nightt5879/HT_2023/通信协议.docx

通信协议

使用的串口为UART0，波特率为115200。数据固定为四个字节的数据。格式与作用如下所示：

0 | 1 | 2 | 3
帧头 | 数据含义 | 高八位 | 低八位
0xAA | 0x | 0x | 0x

数据含义：

0x02：发送图片（HT32 to 8266）

这里就没有数据了，高八低八直接写0x00了。

识别是否成功（8266 to HT32）

单字符：

0x00：失败

0x01：成功

URAT1:to su-o3T 115200，UART0：HT32 to ESP8266

数据分为两种，分别为带数据的和不带数据的。

①带数据的：

1 | 2 | 3 | 4 | 5 | 6 | 7
帧头 | | 序号 | 变量a | 变量b | 帧尾
0x55 | 0xAA | 0x | 0x | 0x | 0x55 | 0xAA

本次通信中主要用于发送温度数据

播报哪种情况根据序号不同有变化

1：温度正常 2：温度过高 3：温度过低
转换之后分为整数部分（a）和小数部分（b）

②不带数据的：

1 | 2 | 3 | 4 | 5
帧头 | | 序号 | 帧尾
0x55 | 0xAA | 0x | 0x55 | 0xAA

主要用于触发固定的语音。

改变序号即可

4：人脸检测成功 5：人脸检测失败 6：完成录入 7：人脸失败过多 8：测温失败过多
