nightt5879/HT_2023/Holtek HT32init/TPMakerExe/_TPMaker/default.ini

[SETTING]
TitleString=Holtek TinyPorgrammer V1.0.0
TextString=TinyPorgrammer for Holtek. Version V1.0.0
NoteString=Type note here, maximum 100 characters.
ImagePath1=
ImagePath2=
VersionString=V1.0.0
APVIDString=0000
APPIDString=0000
APINFString=00
IAPVIDString=0000
IAPPIDString=0000
IAPINFString=00
IDigestEn=1
IDIGESTString=0000
CMDKEYPath=
CMDKEYEn=1
