nightt5879/HT_2023/Holtek HT32init/TPMakerExe/_TPMaker/setting.ini

[SETTING]
TitleString=HT32 IAP
TextString=HT32 IAP
NoteString=HT32 IAP
ImagePath1=.\Image\20181025_V100_AP_Encrypt.bin
ImagePath2=
VersionString=V100
APVIDString=1234
APPIDString=0002
APINFString=00
IAPVIDString=1234
IAPPIDString=0001
IAPINFString=00
IDigestEn=1
IDIGESTString=Console mode error!
CMDKEYPath=.\Config\Command_Key.bin
CMDKEYEn=1
