nightt5879/HT_2023/Holtek HT32init/HT32_M0+/USBDemo/Mass_Storage/ram_disk.c

/*********************************************************************************************************//**
 * @file    USBD/Mass_Storage/ram_disk.c
 * @version $Rev:: 330          $
 * @date    $Date:: 2016-04-14 #$
 * @brief   The RAM Disk related function.
 *************************************************************************************************************
 * @attention
 *
 * Firmware Disclaimer Information
 *
 * 1. The customer hereby acknowledges and agrees that the program technical documentation, including the
 *    code, which is supplied by Holtek Semiconductor Inc., (hereinafter referred to as "HOLTEK") is the
 *    proprietary and confidential intellectual property of HOLTEK, and is protected by copyright law and
 *    other intellectual property laws.
 *
 * 2. The customer hereby acknowledges and agrees that the program technical documentation, including the
 *    code, is confidential information belonging to HOLTEK, and must not be disclosed to any third parties
 *    other than HOLTEK and the customer.
 *
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
 * <h2><center>Copyright (C) Holtek Semiconductor Inc. All rights reserved</center></h2>
 ************************************************************************************************************/

/* Includes ------------------------------------------------------------------------------------------------*/
#include "ram_disk.h"

/** @addtogroup HT32_Series_Peripheral_Examples HT32 Peripheral Examples
  * @{
  */

/** @addtogroup USBD_Examples USBD
  * @{
  */

/** @addtogroup Mass_Storage
  * @{
  */


/* Private macro -------------------------------------------------------------------------------------------*/
#define HALT_2_BYTE(Val)                     ((u8)(Val & 0x00FF)), ((u8)((Val & 0xFF00) >> 8))
#define WORD_2_BYTE(Val)                     ((u8)((Val & 0x000000FF) >> 0 )), \
                                             ((u8)((Val & 0x0000FF00) >> 8 )), \
                                             ((u8)((Val & 0x00FF0000) >> 16)), \
                                             ((u8)((Val & 0xFF000000) >> 24))

/* Private variables ---------------------------------------------------------------------------------------*/
__ALIGN4 static u8 guMemory0[RAMDISK0_MemorySize] =
{
/* BOOT (512 Bytes)                                                                                         */
0xEB, 60, 0x90,                                 /* Dummy jump instruction:                                  */
'M', 'S', 'D', 'O', 'S', '5', '.', '0',         /* OEM Name:                                                */
                                                /* DOS 3.0 BPB                                              */
0x00, 0x02,                                     /* Bytes per logical sector                                 */
0x01,                                           /* Logical sectors per cluster                              */
0x01, 0x00,                                     /* Reserved logical sector count                            */
0x01,                                           /* Number of File Allocation Tables                         */
0x10, 0x00,                                     /* Maximum number of FAT root directory entries (nx32 Bytes)*/
HALT_2_BYTE(RAMDISK0_BlockCount),               /* Total logical sectors                                    */
0xF8,                                           /* Media descriptor                                         */
0x01, 0x00,                                     /* Logical sectors per File Allocation Table                */

0x01, 0x00,                                     /* Sectors per track for disks                              */
0x01, 0x00,                                     /* Number of heads for disks                                */

0x00, 0x00, 0x00, 0x00,                         /* Count of hidden sectors preceding the partition          */
0x00, 0x00, 0x00, 0x00,                         /* Total logical sectors (if greater than 65535)            */
0x00,                                           /* Physical drive number, 00 for first removable media      */
0x00,                                           /* Reserved                                                 */
0x29,                                           /* Extended boot signature                                  */
0x04, 0x03, 0x02, 0x01,                         /* Volume ID (serial number)                                */
'H', 'O', 'L', 'T', 'E', 'K', ' ', 'D',         /* Partition Volume Label                                   */
'I', 'S', 'K',
'F', 'A', 'T', '1', '2', ' ', ' ', ' ',         /* File system type (FAT12)                                 */

0x33, 0xC9,
0x8E, 0xD1, 0xBC, 0xF0, 0x7B, 0x8E, 0xD9, 0xB8, 0x00, 0x20, 0x8E, 0xC0, 0xFC, 0xBD, 0x00, 0x7C,
0x38, 0x4E, 0x24, 0x7D, 0x24, 0x8B, 0xC1, 0x99, 0xE8, 0x3C, 0x01, 0x72, 0x1C, 0x83, 0xEB, 0x3A,
0x66, 0xA1, 0x1C, 0x7C, 0x26, 0x66, 0x3B, 0x07, 0x26, 0x8A, 0x57, 0xFC, 0x75, 0x06, 0x80, 0xCA,
0x02, 0x88, 0x56, 0x02, 0x80, 0xC3, 0x10, 0x73, 0xEB, 0x33, 0xC9, 0x8A, 0x46, 0x10, 0x98, 0xF7,
0x66, 0x16, 0x03, 0x46, 0x1C, 0x13, 0x56, 0x1E, 0x03, 0x46, 0x0E, 0x13, 0xD1, 0x8B, 0x76, 0x11,
0x60, 0x89, 0x46, 0xFC, 0x89, 0x56, 0xFE, 0xB8, 0x20, 0x00, 0xF7, 0xE6, 0x8B, 0x5E, 0x0B, 0x03,
0xC3, 0x48, 0xF7, 0xF3, 0x01, 0x46, 0xFC, 0x11, 0x4E, 0xFE, 0x61, 0xBF, 0x00, 0x00, 0xE8, 0xE6,
0x00, 0x72, 0x39, 0x26, 0x38, 0x2D, 0x74, 0x17, 0x60, 0xB1, 0x0B, 0xBE, 0xA1, 0x7D, 0xF3, 0xA6,
0x61, 0x74, 0x32, 0x4E, 0x74, 0x09, 0x83, 0xC7, 0x20, 0x3B, 0xFB, 0x72, 0xE6, 0xEB, 0xDC, 0xA0,
0xFB, 0x7D, 0xB4, 0x7D, 0x8B, 0xF0, 0xAC, 0x98, 0x40, 0x74, 0x0C, 0x48, 0x74, 0x13, 0xB4, 0x0E,
0xBB, 0x07, 0x00, 0xCD, 0x10, 0xEB, 0xEF, 0xA0, 0xFD, 0x7D, 0xEB, 0xE6, 0xA0, 0xFC, 0x7D, 0xEB,
0xE1, 0xCD, 0x16, 0xCD, 0x19, 0x26, 0x8B, 0x55, 0x1A, 0x52, 0xB0, 0x01, 0xBB, 0x00, 0x00, 0xE8,
0x3B, 0x00, 0x72, 0xE8, 0x5B, 0x8A, 0x56, 0x24, 0xBE, 0x0B, 0x7C, 0x8B, 0xFC, 0xC7, 0x46, 0xF0,
0x3D, 0x7D, 0xC7, 0x46, 0xF4, 0x29, 0x7D, 0x8C, 0xD9, 0x89, 0x4E, 0xF2, 0x89, 0x4E, 0xF6, 0xC6,
0x06, 0x96, 0x7D, 0xCB, 0xEA, 0x03, 0x00, 0x00, 0x20, 0x0F, 0xB6, 0xC8, 0x66, 0x8B, 0x46, 0xF8,
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
0x00, 0x00, 0x00, 0x00, 0x00, 0x00, 0x00, 0x00, 0x00, 0x00, 0x00, 0x00, 0x00, 0x00, 0x00, 0x00,
0x00, 0x00, 0x00, 0x00, 0x00, 0x00, 0x00, 0x00, 0x00, 0x00, 0x00, 0x00, 0x00, 0x00, 0x00, 0x00,
0x00, 0x00, 0x00, 0x00, 0x00, 0x00, 0x00, 0x00, 0x00, 0x00, 0x00, 0x00, 0x00, 0x00, 0x00, 0x00,
0x00, 0x00, 0x00, 0x00, 0x00, 0x00, 0x00, 0x00, 0x00, 0x00, 0x00, 0x00, 0x00, 0x00, 0x00, 0x00,
0x00, 0x00, 0x00, 0x00, 0x00, 0x00, 0x00, 0x00, 0x00, 0x00, 0x00, 0x00, 0x00, 0x00, 0x00, 0x00,
0x00, 0x00, 0x00, 0x00, 0x00, 0x00, 0x00, 0x00, 0x00, 0x00, 0x00, 0x00, 0x00,

/* Root (512 Bytes)                                                                                         */
'H' , 'o' , 'l' , 't' , 'e' , 'k' , ' ' , 'D' , /* Short file name                                          */
'i' , 's' , 'k' ,                               /* Short file extension                                     */
0x28,                                           /* File Attributes: 0x28 for Volume Label                   */
0x00, 0x00, 0x00, 0x00,
0x00, 0x00,
0x00, 0x00, 0x00, 0x00, 0x00, 0x00, 0x00, 0x00, 0x00, 0x00, 0x00, 0x00, 0x00, 0x00,

'R' , 'E' , 'A' , 'D' , 'M' , 'E' , ' ' , ' ' , /* Short file name                                          */
'T' , 'X' , 'T' ,                               /* Short file extension                                     */
0x21,                                           /* File Attributes: 0x21 for read only Archive              */
0x00, 0x00,                                     /* Reserved                                                 */
0x42, 0x08,                                     /* Create time                                              */
0x2A, 0x40,                                     /* Create date                                              */
0x3E, 0x40,                                     /* Last access date                                         */
0x00, 0x00,                                     /* Reserved                                                 */
0x10, 0xA2,                                     /* Last modified time                                       */
0x34, 0x40,                                     /* Last modified date                                       */
0x02, 0x00,                                     /* Start of file in clusters                                */
WORD_2_BYTE(55),                                /* File size in bytes                                       */

0x00, 0x00, 0x00, 0x00, 0x00, 0x00, 0x00, 0x00, 0x00, 0x00, 0x00, 0x00, 0x00, 0x00, 0x00, 0x00,
0x00, 0x00, 0x00, 0x00, 0x00, 0x00, 0x00, 0x00, 0x00, 0x00, 0x00, 0x00, 0x00, 0x00, 0x00, 0x00,
0x00, 0x00, 0x00, 0x00, 0x00, 0x00, 0x00, 0x00, 0x00, 0x00, 0x00, 0x00, 0x00, 0x00, 0x00, 0x00,
0x00, 0x00, 0x00, 0x00, 0x00, 0x00, 0x00, 0x00, 0x00, 0x00, 0x00, 0x00, 0x00, 0x00, 0x00, 0x00,
0x00, 0x00, 0x00, 0x00, 0x00, 0x00, 0x00, 0x00, 0x00, 0x00, 0x00, 0x00, 0x00, 0x00, 0x00, 0x00,
0x00, 0x00, 0x00, 0x00, 0x00, 0x00, 0x00, 0x00, 0x00, 0x00, 0x00, 0x00, 0x00, 0x00, 0x00, 0x00,
0x00, 0x00, 0x00, 0x00, 0x00, 0x00, 0x00, 0x00, 0x00, 0x00, 0x00, 0x00, 0x00, 0x00, 0x00, 0x00,
0x00, 0x00, 0x00, 0x00, 0x00, 0x00, 0x00, 0x00, 0x00, 0x00, 0x00, 0x00, 0x00, 0x00, 0x00, 0x00,
0x00, 0x00, 0x00, 0x00, 0x00, 0x00, 0x00, 0x00, 0x00, 0x00, 0x00, 0x00, 0x00, 0x00, 0x00, 0x00,
0x00, 0x00, 0x00, 0x00, 0x00, 0x00, 0x00, 0x00, 0x00, 0x00, 0x00, 0x00, 0x00, 0x00, 0x00, 0x00,
0x00, 0x00, 0x00, 0x00, 0x00, 0x00, 0x00, 0x00, 0x00, 0x00, 0x00, 0x00, 0x00, 0x00, 0x00, 0x00,
0x00, 0x00, 0x00, 0x00, 0x00, 0x00, 0x00, 0x00, 0x00, 0x00, 0x00, 0x00, 0x00, 0x00, 0x00, 0x00,
0x00, 0x00, 0x00, 0x00, 0x00, 0x00, 0x00, 0x00, 0x00, 0x00, 0x00, 0x00, 0x00, 0x00, 0x00, 0x00,
0x00, 0x00, 0x00, 0x00, 0x00, 0x00, 0x00, 0x00, 0x00, 0x00, 0x00, 0x00, 0x00, 0x00, 0x00, 0x00,
0x00, 0x00, 0x00, 0x00, 0x00, 0x00, 0x00, 0x00, 0x00, 0x00, 0x00, 0x00, 0x00, 0x00, 0x00, 0x00,
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
0x00, 0x00, 0x00, 0x00, 0x00, 0x00, 0x00, 0x00, 0x00, 0x00, 0x00, 0x00, 0x00, 0x00, 0x00, 0x00,
0x00, 0x00, 0x00, 0x00, 0x00, 0x00, 0x00, 0x00, 0x00, 0x00, 0x00, 0x00, 0x00, 0x00, 0x00, 0x00,
0x00, 0x00, 0x00, 0x00, 0x00, 0x00, 0x00, 0x00, 0x00, 0x00, 0x00, 0x00, 0x00, 0x00, 0x00, 0x00,
0x00, 0x00, 0x00, 0x00, 0x00, 0x00, 0x00, 0x00, 0x00, 0x00, 0x00, 0x00, 0x00, 0x00, 0x00, 0x00,
};

#if (BOT_RAM_DISK1 == 1)
__ALIGN4 static u8 guMemory1[RAMDISK1_MemorySize] =
{
/* BOOT (512 Bytes)                                                                                         */
0xEB, 60, 0x90,                                 /* Dummy jump instruction:                                  */
'M', 'S', 'D', 'O', 'S', '5', '.', '0',         /* OEM Name:                                                */
                                                /* DOS 3.0 BPB                                              */
0x00, 0x02,                                     /* Bytes per logical sector                                 */
0x01,                                           /* Logical sectors per cluster                              */
0x01, 0x00,                                     /* Reserved logical sector count                            */
0x01,                                           /* Number of File Allocation Tables                         */
0x10, 0x00,                                     /* Maximum number of FAT root directory entries (nx32 Bytes)*/
HALT_2_BYTE(RAMDISK1_BlockCount),               /* Total logical sectors                                    */
0xF8,                                           /* Media descriptor                                         */
0x01, 0x00,                                     /* Logical sectors per File Allocation Table                */

0x01, 0x00,                                     /* Sectors per track for disks                              */
0x01, 0x00,                                     /* Number of heads for disks                                */

0x00, 0x00, 0x00, 0x00,                         /* Count of hidden sectors preceding the partition          */
0x00, 0x00, 0x00, 0x00,                         /* Total logical sectors (if greater than 65535)            */
0x00,                                           /* Physical drive number, 00 for first removable media      */
0x00,                                           /* Reserved                                                 */
0x29,                                           /* Extended boot signature                                  */
0x04, 0x03, 0x02, 0x01,                         /* Volume ID (serial number)                                */
'H', 'O', 'L', 'T', 'E', 'K', ' ', 'D',         /* Partition Volume Label                                   */
'I', 'S', 'K',
'F', 'A', 'T', '1', '2', ' ', ' ', ' ',         /* File system type (FAT12)                                 */

0x33, 0xC9,
0x8E, 0xD1, 0xBC, 0xF0, 0x7B, 0x8E, 0xD9, 0xB8, 0x00, 0x20, 0x8E, 0xC0, 0xFC, 0xBD, 0x00, 0x7C,
0x38, 0x4E, 0x24, 0x7D, 0x24, 0x8B, 0xC1, 0x99, 0xE8, 0x3C, 0x01, 0x72, 0x1C, 0x83, 0xEB, 0x3A,
0x66, 0xA1, 0x1C, 0x7C, 0x26, 0x66, 0x3B, 0x07, 0x26, 0x8A, 0x57, 0xFC, 0x75, 0x06, 0x80, 0xCA,
0x02, 0x88, 0x56, 0x02, 0x80, 0xC3, 0x10, 0x73, 0xEB, 0x33, 0xC9, 0x8A, 0x46, 0x10, 0x98, 0xF7,
0x66, 0x16, 0x03, 0x46, 0x1C, 0x13, 0x56, 0x1E, 0x03, 0x46, 0x0E, 0x13, 0xD1, 0x8B, 0x76, 0x11,
0x60, 0x89, 0x46, 0xFC, 0x89, 0x56, 0xFE, 0xB8, 0x20, 0x00, 0xF7, 0xE6, 0x8B, 0x5E, 0x0B, 0x03,
0xC3, 0x48, 0xF7, 0xF3, 0x01, 0x46, 0xFC, 0x11, 0x4E, 0xFE, 0x61, 0xBF, 0x00, 0x00, 0xE8, 0xE6,
0x00, 0x72, 0x39, 0x26, 0x38, 0x2D, 0x74, 0x17, 0x60, 0xB1, 0x0B, 0xBE, 0xA1, 0x7D, 0xF3, 0xA6,
0x61, 0x74, 0x32, 0x4E, 0x74, 0x09, 0x83, 0xC7, 0x20, 0x3B, 0xFB, 0x72, 0xE6, 0xEB, 0xDC, 0xA0,
0xFB, 0x7D, 0xB4, 0x7D, 0x8B, 0xF0, 0xAC, 0x98, 0x40, 0x74, 0x0C, 0x48, 0x74, 0x13, 0xB4, 0x0E,
0xBB, 0x07, 0x00, 0xCD, 0x10, 0xEB, 0xEF, 0xA0, 0xFD, 0x7D, 0xEB, 0xE6, 0xA0, 0xFC, 0x7D, 0xEB,
0xE1, 0xCD, 0x16, 0xCD, 0x19, 0x26, 0x8B, 0x55, 0x1A, 0x52, 0xB0, 0x01, 0xBB, 0x00, 0x00, 0xE8,
0x3B, 0x00, 0x72, 0xE8, 0x5B, 0x8A, 0x56, 0x24, 0xBE, 0x0B, 0x7C, 0x8B, 0xFC, 0xC7, 0x46, 0xF0,
0x3D, 0x7D, 0xC7, 0x46, 0xF4, 0x29, 0x7D, 0x8C, 0xD9, 0x89, 0x4E, 0xF2, 0x89, 0x4E, 0xF6, 0xC6,
0x06, 0x96, 0x7D, 0xCB, 0xEA, 0x03, 0x00, 0x00, 0x20, 0x0F, 0xB6, 0xC8, 0x66, 0x8B, 0x46, 0xF8,
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
0x00, 0x00, 0x00, 0x00, 0x00, 0x00, 0x00, 0x00, 0x00, 0x00, 0x00, 0x00, 0x00, 0x00, 0x00, 0x00,
0x00, 0x00, 0x00, 0x00, 0x00, 0x00, 0x00, 0x00, 0x00, 0x00, 0x00, 0x00, 0x00, 0x00, 0x00, 0x00,
0x00, 0x00, 0x00, 0x00, 0x00, 0x00, 0x00, 0x00, 0x00, 0x00, 0x00, 0x00, 0x00, 0x00, 0x00, 0x00,
0x00, 0x00, 0x00, 0x00, 0x00, 0x00, 0x00, 0x00, 0x00, 0x00, 0x00, 0x00, 0x00, 0x00, 0x00, 0x00,
0x00, 0x00, 0x00, 0x00, 0x00, 0x00, 0x00, 0x00, 0x00, 0x00, 0x00, 0x00, 0x00, 0x00, 0x00, 0x00,
0x00, 0x00, 0x00, 0x00, 0x00, 0x00, 0x00, 0x00, 0x00, 0x00, 0x00, 0x00, 0x00,

/* Root (512 Bytes)                                                                                         */
'H' , 'o' , 'l' , 't' , 'e' , 'k' , ' ' , 'D' , /* Short file name                                          */
'i' , 's' , 'k' ,                               /* Short file extension                                     */
0x28,                                           /* File Attributes: 0x28 for Volume Label                   */
0x00, 0x00, 0x00, 0x00,
0x00, 0x00,
0x00, 0x00, 0x00, 0x00, 0x00, 0x00, 0x00, 0x00, 0x00, 0x00, 0x00, 0x00, 0x00, 0x00,

'R' , 'E' , 'A' , 'D' , 'M' , 'E' , ' ' , ' ' , /* Short file name                                          */
'T' , 'X' , 'T' ,                               /* Short file extension                                     */
0x21,                                           /* File Attributes: 0x21 for read only Archive              */
0x00, 0x00,                                     /* Reserved                                                 */
0x42, 0x08,                                     /* Create time                                              */
0x2A, 0x40,                                     /* Create date                                              */
0x3E, 0x40,                                     /* Last access date                                         */
0x00, 0x00,                                     /* Reserved                                                 */
0x10, 0xA2,                                     /* Last modified time                                       */
0x34, 0x40,                                     /* Last modified date                                       */
0x02, 0x00,                                     /* Start of file in clusters                                */
WORD_2_BYTE(55),                                /* File size in bytes                                       */

0x00, 0x00, 0x00, 0x00, 0x00, 0x00, 0x00, 0x00, 0x00, 0x00, 0x00, 0x00, 0x00, 0x00, 0x00, 0x00,
0x00, 0x00, 0x00, 0x00, 0x00, 0x00, 0x00, 0x00, 0x00, 0x00, 0x00, 0x00, 0x00, 0x00, 0x00, 0x00,
0x00, 0x00, 0x00, 0x00, 0x00, 0x00, 0x00, 0x00, 0x00, 0x00, 0x00, 0x00, 0x00, 0x00, 0x00, 0x00,
0x00, 0x00, 0x00, 0x00, 0x00, 0x00, 0x00, 0x00, 0x00, 0x00, 0x00, 0x00, 0x00, 0x00, 0x00, 0x00,
0x00, 0x00, 0x00, 0x00, 0x00, 0x00, 0x00, 0x00, 0x00, 0x00, 0x00, 0x00, 0x00, 0x00, 0x00, 0x00,
0x00, 0x00, 0x00, 0x00, 0x00, 0x00, 0x00, 0x00, 0x00, 0x00, 0x00, 0x00, 0x00, 0x00, 0x00, 0x00,
0x00, 0x00, 0x00, 0x00, 0x00, 0x00, 0x00, 0x00, 0x00, 0x00, 0x00, 0x00, 0x00, 0x00, 0x00, 0x00,
0x00, 0x00, 0x00, 0x00, 0x00, 0x00, 0x00, 0x00, 0x00, 0x00, 0x00, 0x00, 0x00, 0x00, 0x00, 0x00,
0x00, 0x00, 0x00, 0x00, 0x00, 0x00, 0x00, 0x00, 0x00, 0x00, 0x00, 0x00, 0x00, 0x00, 0x00, 0x00,
0x00, 0x00, 0x00, 0x00, 0x00, 0x00, 0x00, 0x00, 0x00, 0x00, 0x00, 0x00, 0x00, 0x00, 0x00, 0x00,
0x00, 0x00, 0x00, 0x00, 0x00, 0x00, 0x00, 0x00, 0x00, 0x00, 0x00, 0x00, 0x00, 0x00, 0x00, 0x00,
0x00, 0x00, 0x00, 0x00, 0x00, 0x00, 0x00, 0x00, 0x00, 0x00, 0x00, 0x00, 0x00, 0x00, 0x00, 0x00,
0x00, 0x00, 0x00, 0x00, 0x00, 0x00, 0x00, 0x00, 0x00, 0x00, 0x00, 0x00, 0x00, 0x00, 0x00, 0x00,
0x00, 0x00, 0x00, 0x00, 0x00, 0x00, 0x00, 0x00, 0x00, 0x00, 0x00, 0x00, 0x00, 0x00, 0x00, 0x00,
0x00, 0x00, 0x00, 0x00, 0x00, 0x00, 0x00, 0x00, 0x00, 0x00, 0x00, 0x00, 0x00, 0x00, 0x00, 0x00,
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
0x00, 0x00, 0x00, 0x00, 0x00, 0x00, 0x00, 0x00, 0x00, 0x00, 0x00, 0x00, 0x00, 0x00, 0x00, 0x00,
0x00, 0x00, 0x00, 0x00, 0x00, 0x00, 0x00, 0x00, 0x00, 0x00, 0x00, 0x00, 0x00, 0x00, 0x00, 0x00,
0x00, 0x00, 0x00, 0x00, 0x00, 0x00, 0x00, 0x00, 0x00, 0x00, 0x00, 0x00, 0x00, 0x00, 0x00, 0x00,
0x00, 0x00, 0x00, 0x00, 0x00, 0x00, 0x00, 0x00, 0x00, 0x00, 0x00, 0x00, 0x00, 0x00, 0x00, 0x00,
};
#endif

u8 bRamDiskUnload[2] = {FALSE};

/* Global functions ----------------------------------------------------------------------------------------*/
/*********************************************************************************************************//**
  * @brief  Read from RAM Disk memory.
  * @param  uId: RAM Disk ID
  * @param  pBuffer: Pointer of data buffer
  * @param  uAddress: Address for read operation
  * @param  uLength: Length for read operation
  * @retval uResult: TRUE or FALSE
  ***********************************************************************************************************/
u32 RAMDISK_Read(u32 uId, u8 **pBuffer, u32 uAddress, u32 uLength)
{
  u32 uResult = TRUE;

  if (uId == RAMDISK0_ID)
  {
    *pBuffer = &(guMemory0[uAddress]);
  }
  #if (BOT_RAM_DISK1 == 1)
  else if (uId == RAMDISK1_ID)
  {
    *pBuffer = &(guMemory1[uAddress]);
  }
  #endif
  else
  {
    uResult = FALSE;
  }

  return uResult;
}

/*********************************************************************************************************//**
  * @brief  Write to RAM Disk memory.
  * @param  uId: RAM Disk ID
  * @param  pBuffer: Pointer of data buffer
  * @param  uAddress: Address for write operation
  * @param  uLength: Length for write operation
  * @retval TRUE or FALSE
  ***********************************************************************************************************/
u32 RAMDISK_Write(u32 uId, u8 *pBuffer, u32 uAddress, u32 uLength)
{
  s32 i;
  u8 *pMemory;

  if (uId == RAMDISK0_ID)
  {
    pMemory = &(guMemory0[uAddress]);
  }
  #if (BOT_RAM_DISK1 == 1)
  else if (uId == RAMDISK1_ID)
  {
    pMemory = &(guMemory1[uAddress]);
  }
  #endif
  else
  {
    return FALSE;
  }

  for (i = uLength - 1; i >= 0; i--)
  {
    pMemory[i] = *(pBuffer + i);
  }

  return TRUE;
}

/*********************************************************************************************************//**
  * @brief  Get RAM Disk Status.
  * @param  uId: RAM Disk ID
  * @param  pSizeInfo: Pointer of media size information
  * @retval TRUE: Always ready for RAM disk
  ***********************************************************************************************************/
u32 RAMDISK_GetStatus(u32 uId, BOT_MediaSize_Typedef *pSizeInfo)
{
  if ((uId == RAMDISK0_ID) && bRamDiskUnload[0])
    return FALSE;
  else if ((uId == RAMDISK1_ID) && bRamDiskUnload[1])
    return FALSE;

  return TRUE;
}

/*********************************************************************************************************//**
  * @brief  Unmount RAM Disk.
  * @param  uId: RAM Disk ID
  ***********************************************************************************************************/
void RAMDISK_Unmount(u32 uId)
{
  if (uId == RAMDISK0_ID)
    bRamDiskUnload[0] = TRUE;
  else if (uId == RAMDISK1_ID)
    bRamDiskUnload[1] = TRUE;
}


/**
  * @}
  */

/**
  * @}
  */

/**
  * @}
  */
