nightt5879/HT_2023/su-03t/jx_firm (7)/jx_firm/uart/jx_uart_send.c

#include "jx_uart_send.h"

// 串口通信消息头
const unsigned char g_uart_send_head[] = {
  0xaa, 0x55
};

// 串口通信消息尾
const unsigned char g_uart_send_foot[] = {
  0x55, 0xaa
};

// 串口发送函数实现
void _uart_send_impl(unsigned char* buff, int len) {
  // TODO: 调用项目实际的串口发送函数
  /*
  int i = 0;
  unsigned char c;
  for (i = 0; i < len; i++) {
    c = buff[i];
    printf("%02X ", c);
  }
  printf("\n");
  */
}

// action: tem_nor
void _uart_tem_nor(char a, char b) {
  uart_param_t param;
  int i = 0;
  unsigned char buff[UART_SEND_MAX] = {0};
  for (i = 0; i < UART_MSG_HEAD_LEN; i++) {
      buff[i + 0] = g_uart_send_head[i];
  }
  buff[2] = U_MSG_tem_nor;
  param.d_char = a;
  buff[3] = param.d_uchar;
  param.d_char = b;
  buff[4] = param.d_uchar;
  for (i = 0; i < UART_MSG_FOOT_LEN; i++) {
      buff[i + 5] = g_uart_send_foot[i];
  }
  _uart_send_impl(buff, 7);
}

// action: tem_high
void _uart_tem_high(char a, char b) {
  uart_param_t param;
  int i = 0;
  unsigned char buff[UART_SEND_MAX] = {0};
  for (i = 0; i < UART_MSG_HEAD_LEN; i++) {
      buff[i + 0] = g_uart_send_head[i];
  }
  buff[2] = U_MSG_tem_high;
  param.d_char = a;
  buff[3] = param.d_uchar;
  param.d_char = b;
  buff[4] = param.d_uchar;
  for (i = 0; i < UART_MSG_FOOT_LEN; i++) {
      buff[i + 5] = g_uart_send_foot[i];
  }
  _uart_send_impl(buff, 7);
}

// action: tem_low
void _uart_tem_low(char a, char b) {
  uart_param_t param;
  int i = 0;
  unsigned char buff[UART_SEND_MAX] = {0};
  for (i = 0; i < UART_MSG_HEAD_LEN; i++) {
      buff[i + 0] = g_uart_send_head[i];
  }
  buff[2] = U_MSG_tem_low;
  param.d_char = a;
  buff[3] = param.d_uchar;
  param.d_char = b;
  buff[4] = param.d_uchar;
  for (i = 0; i < UART_MSG_FOOT_LEN; i++) {
      buff[i + 5] = g_uart_send_foot[i];
  }
  _uart_send_impl(buff, 7);
}

// action: face_suc
void _uart_face_suc() {
  uart_param_t param;
  int i = 0;
  unsigned char buff[UART_SEND_MAX] = {0};
  for (i = 0; i < UART_MSG_HEAD_LEN; i++) {
      buff[i + 0] = g_uart_send_head[i];
  }
  buff[2] = U_MSG_face_suc;
  for (i = 0; i < UART_MSG_FOOT_LEN; i++) {
      buff[i + 3] = g_uart_send_foot[i];
  }
  _uart_send_impl(buff, 5);
}

// action: face_fail
void _uart_face_fail() {
  uart_param_t param;
  int i = 0;
  unsigned char buff[UART_SEND_MAX] = {0};
  for (i = 0; i < UART_MSG_HEAD_LEN; i++) {
      buff[i + 0] = g_uart_send_head[i];
  }
  buff[2] = U_MSG_face_fail;
  for (i = 0; i < UART_MSG_FOOT_LEN; i++) {
      buff[i + 3] = g_uart_send_foot[i];
  }
  _uart_send_impl(buff, 5);
}

// action: finish
void _uart_finish() {
  uart_param_t param;
  int i = 0;
  unsigned char buff[UART_SEND_MAX] = {0};
  for (i = 0; i < UART_MSG_HEAD_LEN; i++) {
      buff[i + 0] = g_uart_send_head[i];
  }
  buff[2] = U_MSG_finish;
  for (i = 0; i < UART_MSG_FOOT_LEN; i++) {
      buff[i + 3] = g_uart_send_foot[i];
  }
  _uart_send_impl(buff, 5);
}

// action: face_out
void _uart_face_out() {
  uart_param_t param;
  int i = 0;
  unsigned char buff[UART_SEND_MAX] = {0};
  for (i = 0; i < UART_MSG_HEAD_LEN; i++) {
      buff[i + 0] = g_uart_send_head[i];
  }
  buff[2] = U_MSG_face_out;
  for (i = 0; i < UART_MSG_FOOT_LEN; i++) {
      buff[i + 3] = g_uart_send_foot[i];
  }
  _uart_send_impl(buff, 5);
}

// action: tem_out
void _uart_tem_out() {
  uart_param_t param;
  int i = 0;
  unsigned char buff[UART_SEND_MAX] = {0};
  for (i = 0; i < UART_MSG_HEAD_LEN; i++) {
      buff[i + 0] = g_uart_send_head[i];
  }
  buff[2] = U_MSG_tem_out;
  for (i = 0; i < UART_MSG_FOOT_LEN; i++) {
      buff[i + 3] = g_uart_send_foot[i];
  }
  _uart_send_impl(buff, 5);
}
