nightt5879/HT_2023/su-03t/jx_firm (7)/jx_firm/uart/jx_uart_send.h

#ifndef JX_UART_SEND_H_
#define JX_UART_SEND_H_

#ifdef __cplusplus
extern "C" {
#endif

// 串口发送消息最大长度
#define UART_SEND_MAX      32
#define UART_MSG_HEAD_LEN  2
#define UART_MSG_FOOT_LEN  2

// 串口发送消息号
#define U_MSG_tem_nor      1
#define U_MSG_tem_high      2
#define U_MSG_tem_low      3
#define U_MSG_face_suc      4
#define U_MSG_face_fail      5
#define U_MSG_finish      6
#define U_MSG_face_out      7
#define U_MSG_tem_out      8

// 串口消息参数类型
typedef union {
  double d_double;
  int d_int;
  unsigned char d_ucs[8];
  char d_char;
  unsigned char d_uchar;
  unsigned long d_long;
  short d_short;
  float d_float;
}uart_param_t;

// 十六位整数转32位整数
void _int16_to_int32(uart_param_t* param) {
  if (sizeof(int) >= 4)
    return;
  unsigned long value = param->d_long;
  unsigned long sign = (value >> 15) & 1;
  unsigned long v = value;
  if (sign)
    v = 0xFFFF0000 | value;
  uart_param_t p;
  p.d_long = v;
  param->d_ucs[0] = p.d_ucs[0];
  param->d_ucs[1] = p.d_ucs[1];
  param->d_ucs[2] = p.d_ucs[2];
  param->d_ucs[3] = p.d_ucs[3];
}

// 浮点数转双精度 
void _float_to_double(uart_param_t* param) {
  if (sizeof(int) >= 4)
    return;
  unsigned long value = param->d_long;
  unsigned long sign = value >> 31;
  unsigned long M = value & 0x007FFFFF;
  unsigned long e =  ((value >> 23 ) & 0xFF) - 127 + 1023;
  uart_param_t p0, p1;  
  p1.d_long = ((sign & 1) << 31) | ((e & 0x7FF) << 20) | (M >> 3);
  p0.d_long = (M & 0x7) << 29;
  param->d_ucs[0] = p0.d_ucs[0];
  param->d_ucs[1] = p0.d_ucs[1];
  param->d_ucs[2] = p0.d_ucs[2];
  param->d_ucs[3] = p0.d_ucs[3];
  param->d_ucs[4] = p1.d_ucs[0];
  param->d_ucs[5] = p1.d_ucs[1];
  param->d_ucs[6] = p1.d_ucs[2];
  param->d_ucs[7] = p1.d_ucs[3];
}

// action: tem_nor
void _uart_tem_nor(char a, char b);

// action: tem_high
void _uart_tem_high(char a, char b);

// action: tem_low
void _uart_tem_low(char a, char b);

// action: face_suc
void _uart_face_suc();

// action: face_fail
void _uart_face_fail();

// action: finish
void _uart_finish();

// action: face_out
void _uart_face_out();

// action: tem_out
void _uart_tem_out();

#ifdef __cplusplus
}
#endif

#endif /*JX_UART_SEND_H_*/
