nightt5879/HT_2023/Holtek HT32init/HT32_M0+/project_template/IP/Example/ht32f5xxxx_01_it.c

/*********************************************************************************************************//**
 * @file    IP/Example/ht32f5xxxx_01_it.c
 * @version $Rev:: 4398         $
 * @date    $Date:: 2019-11-14 #$
 * @brief   This file provides all interrupt service routine.
 *************************************************************************************************************
 * @attention
 *
 * Firmware Disclaimer Information
 *
 * 1. The customer hereby acknowledges and agrees that the program technical documentation, including the
 *    code, which is supplied by Holtek Semiconductor Inc., (hereinafter referred to as "HOLTEK") is the
 *    proprietary and confidential intellectual property of HOLTEK, and is protected by copyright law and
 *    other intellectual property laws.
 *
 * 2. The customer hereby acknowledges and agrees that the program technical documentation, including the
 *    code, is confidential information belonging to HOLTEK, and must not be disclosed to any third parties
 *    other than HOLTEK and the customer.
 *
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
 * <h2><center>Copyright (C) Holtek Semiconductor Inc. All rights reserved</center></h2>
 ************************************************************************************************************/

/* Includes ------------------------------------------------------------------------------------------------*/
#include "ht32.h"

/** @addtogroup Project_Template Project Template
  * @{
  */

/** @addtogroup IP_Examples IP
  * @{
  */

/** @addtogroup Example
  * @{
  */


/* Global functions ----------------------------------------------------------------------------------------*/
/*********************************************************************************************************//**
 * @brief   This function handles NMI exception.
 * @retval  None
 ************************************************************************************************************/
void NMI_Handler(void)
{
}

/*********************************************************************************************************//**
 * @brief   This function handles Hard Fault exception.
 * @retval  None
 ************************************************************************************************************/
void HardFault_Handler(void)
{
  #if 1

  static vu32 gIsContinue = 0;
  /*--------------------------------------------------------------------------------------------------------*/
  /* For development FW, MCU run into the while loop when the hardfault occurred.                           */
  /* 1. Stack Checking                                                                                      */
  /*    When a hard fault exception occurs, MCU push following register into the stack (main or process     */
  /*    stack). Confirm R13(SP) value in the Register Window and typing it to the Memory Windows, you can   */
  /*    check following register, especially the PC value (indicate the last instruction before hard fault).*/
  /*    SP + 0x00    0x04    0x08    0x0C    0x10    0x14    0x18    0x1C                                   */
  /*           R0      R1      R2      R3     R12      LR      PC    xPSR                                   */
  while (gIsContinue == 0)
  {
  }
  /* 2. Step Out to Find the Clue                                                                           */
  /*    Change the variable "gIsContinue" to any other value than zero in a Local or Watch Window, then     */
  /*    step out the HardFault_Handler to reach the first instruction after the instruction which caused    */
  /*    the hard fault.                                                                                     */
  /*--------------------------------------------------------------------------------------------------------*/

  #else

  /*--------------------------------------------------------------------------------------------------------*/
  /* For production FW, you shall consider to reboot the system when hardfault occurred.                    */
  /*--------------------------------------------------------------------------------------------------------*/
  NVIC_SystemReset();

  #endif
}

/*********************************************************************************************************//**
 * @brief   This function handles SVCall exception.
 * @retval  None
 ************************************************************************************************************/
void SVC_Handler(void)
{
}

/*********************************************************************************************************//**
 * @brief   This function handles PendSVC exception.
 * @retval  None
 ************************************************************************************************************/
void PendSV_Handler(void)
{
}

/*********************************************************************************************************//**
 * @brief   This function handles SysTick Handler.
 * @retval  None
 ************************************************************************************************************/
void SysTick_Handler(void)
{
}

/*********************************************************************************************************//**
 * @brief   This function handles LVD & BOD interrupt.
 * @retval  None
 ************************************************************************************************************/
//void LVD_BOD_IRQHandler(void)
//{
//}

/*********************************************************************************************************//**
 * @brief   This function handles RTC interrupt.
 * @retval  None
 ************************************************************************************************************/
//void RTC_IRQHandler(void)
//{
//}

/*********************************************************************************************************//**
 * @brief   This function handles Flash interrupt.
 * @retval  None
 ************************************************************************************************************/
//void FLASH_IRQHandler(void)
//{
//}

/*********************************************************************************************************//**
 * @brief   This function handles Wake-up interrupt.
 * @retval  None
 ************************************************************************************************************/
//void EVWUP_IRQHandler(void)
//{
//}

/*********************************************************************************************************//**
 * @brief   This function handles EXTI interrupt.
 * @retval  None
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
 * @brief   This function handles I2S interrupt.
 * @retval  None
 ************************************************************************************************************/
//void I2S_IRQHandler(void)
//{
//}

/*********************************************************************************************************//**
 * @brief   This function handles USB interrupt.
 * @retval  None
 ************************************************************************************************************/
//void USB_IRQHandler(void)
//{
//}

/*********************************************************************************************************//**
 * @brief   This function handles PDMA interrupt.
 * @retval  None
 ************************************************************************************************************/
//void PDMA_CH0_1_IRQHandler(void)
//{
//}

/*********************************************************************************************************//**
 * @brief   This function handles PDMA interrupt.
 * @retval  None
 ************************************************************************************************************/
//void PDMA_CH2_5_IRQHandler(void)
//{
//}


/**
  * @}
  */

/**
  * @}
  */

/**
  * @}
  */
